Billiardchalktheif/Cargo_gaurdian_system/docs/(지정 비율) 작동코드 및 파이썬 프로그램.docx

<작동코드>-아두이노

// =====================================================

// 화물지킴이 최종 코드 - ESP32

// 퍼센트 방식 + 축적 감지 + raw/퍼센트 동시 출력

// =====================================================

#include <Wire.h>

#include <VL53L1X.h>

#include <HX711.h>

#include <LiquidCrystal_I2C.h>

#include <WiFi.h>

#include <WiFiUdp.h>

// ── Wi-Fi 설정 ──

const char* ssid = "Billiardchalktheif";

const char* password = "goqudeo1!";

const int UDP_PORT = 12345;

WiFiUDP udp;

// ── 핀 정의 ──

#define XSHUT_PIN 4

#define BUZZER_PIN 13

#define DOUT 16

#define SCK_HX 17

#define MPU_ADDR 0x68

#define RESET_BTN 12

#define MUTE_BTN 14

// ── 퍼센트 임계값 (실험 후 수정) ──

// 각 센서가 기준값 대비 몇 % 변화 시 경보

#define TILT_B 0.15 // 15% 변화 → 경고

#define TILT_C 0.25 // 25% 변화 → 위험

#define TENSION_B 0.15 // 15% 감소 → 경고

#define TENSION_C 0.30 // 30% 감소 → 위험

#define DIST_B 0.10 // 10% 변화 → 경고

#define DIST_C 0.20 // 20% 변화 → 위험

// ── 축적 감지 횟수 ──

#define ACCUM_COUNT 3 // 3회 연속 감지 시 경보

// ── 객체 생성 ──

VL53L1X vl53;

HX711 scale;

LiquidCrystal_I2C lcd(0x27, 16, 2);

long baseRaw = 0;

int baseDist = 0;

float baseTilt = 0;

bool isMuted = false;

// ── 축적 카운터 ──

int accumT = 0;

int accumF = 0;

int accumD = 0;

// ── 이동평균 필터 ──

#define FILTER_SIZE 5

long tensorBuf[FILTER_SIZE] = {0};

int distBuf[FILTER_SIZE] = {0};

float tiltBuf[FILTER_SIZE] = {0};

int fIdx = 0;

// ── MPU6050 직접 제어 ──

void mpuInit() {

Wire.beginTransmission(MPU_ADDR);

Wire.write(0x6B);

Wire.write(0x00);

Wire.endTransmission();

}

float getRawTilt() {

Wire.beginTransmission(MPU_ADDR);

Wire.write(0x3B);

Wire.endTransmission(false);

Wire.requestFrom(MPU_ADDR, 6, true);

int16_t ax = Wire.read() << 8 | Wire.read();

int16_t ay = Wire.read() << 8 | Wire.read();

int16_t az = Wire.read() << 8 | Wire.read();

float accY = ay / 16384.0;

float accZ = az / 16384.0;

tiltBuf[fIdx] = abs(atan2(accY, accZ) * 180.0 / PI);

float sum = 0;

for (int i = 0; i < FILTER_SIZE; i++) sum += tiltBuf[i];

return sum / FILTER_SIZE;

}

float getTilt() {

return abs(getRawTilt() - baseTilt);

}

long getFilteredTension() {

tensorBuf[fIdx] = scale.get_value(3);

long sum = 0;

for (int i = 0; i < FILTER_SIZE; i++) sum += tensorBuf[i];

return sum / FILTER_SIZE;

}

int getFilteredDist() {

distBuf[fIdx] = vl53.read();

int sum = 0;

for (int i = 0; i < FILTER_SIZE; i++) sum += distBuf[i];

return sum / FILTER_SIZE;

}

void sendData(String data) {

if (WiFi.status() == WL_CONNECTED) {

udp.beginPacket("255.255.255.255", UDP_PORT);

udp.print(data);

udp.endPacket();

}

Serial.println(data);

}

void resetBaseline() {

lcd.clear();

lcd.print("Resetting...");

delay(500);

scale.tare();

for (int i = 0; i < FILTER_SIZE; i++) {

tensorBuf[i] = scale.get_value(3);

distBuf[i] = vl53.read();

tiltBuf[i] = getRawTilt();

delay(100);

}

baseRaw = getFilteredTension();

baseDist = getFilteredDist();

baseTilt = getRawTilt();

// 축적 카운터 초기화

accumT = 0;

accumF = 0;

accumD = 0;

sendData("RESET");

lcd.clear();

lcd.print("RESET OK!");

delay(1000);

}

void setup() {

Serial.begin(115200);

Wire.begin(21, 22);

pinMode(BUZZER_PIN, OUTPUT);

pinMode(XSHUT_PIN, OUTPUT);

pinMode(RESET_BTN, INPUT_PULLUP);

pinMode(MUTE_BTN, INPUT_PULLUP);

lcd.init();

lcd.backlight();

lcd.setCursor(0, 0); lcd.print("Cargo Guardian");

lcd.setCursor(0, 1); lcd.print("Connecting...");

WiFi.begin(ssid, password);

int retry = 0;

while (WiFi.status() != WL_CONNECTED && retry < 20) {

delay(500);

Serial.print(".");

retry++;

}

if (WiFi.status() == WL_CONNECTED) {

Serial.println("\nWi-Fi 연결 성공!");

lcd.clear();

lcd.print("WiFi OK!");

lcd.setCursor(0, 1);

lcd.print(WiFi.localIP());

delay(2000);

} else {

Serial.println("\nWi-Fi 실패 - 오프라인 모드");

lcd.clear();

lcd.print("WiFi FAIL");

lcd.setCursor(0, 1);

lcd.print("Offline Mode");

delay(2000);

}

udp.begin(UDP_PORT);

mpuInit();

delay(100);

digitalWrite(XSHUT_PIN, LOW); delay(10);

digitalWrite(XSHUT_PIN, HIGH); delay(10);

vl53.setTimeout(500);

if (!vl53.init()) {

lcd.clear(); lcd.print("VL53 ERROR!");

while(1);

}

vl53.setDistanceMode(VL53L1X::Long);

vl53.startContinuous(50);

scale.begin(DOUT, SCK_HX);

delay(500);

scale.tare();

resetBaseline();

lcd.clear();

lcd.print("Ready!");

delay(1000);

}

void loop() {

// ── 영점 리셋 버튼 ──

if (digitalRead(RESET_BTN) == LOW) {

delay(50);

if (digitalRead(RESET_BTN) == LOW) {

resetBaseline();

while (digitalRead(RESET_BTN) == LOW);

}

}

// ── 음소거 버튼 ──

if (digitalRead(MUTE_BTN) == LOW) {

delay(50);

if (digitalRead(MUTE_BTN) == LOW) {

isMuted = !isMuted;

noTone(BUZZER_PIN);

lcd.clear();

if (isMuted) {

lcd.print("MUTE ON");

lcd.setCursor(0,1); lcd.print("Buzzer OFF");

} else {

lcd.print("MUTE OFF");

lcd.setCursor(0,1); lcd.print("Buzzer ON");

}

delay(800);

while (digitalRead(MUTE_BTN) == LOW);

}

}

// ── 센서 raw값 읽기 ──

float rawTilt = getTilt(); // 도(°)

long rawTension = getFilteredTension(); // raw값

int rawDist = getFilteredDist(); // mm

fIdx = (fIdx + 1) % FILTER_SIZE;

// ── 퍼센트 변화율 계산 ──

float tiltPct = rawTilt / (abs(baseTilt) + 1.0);

float tensionPct = (float)(baseRaw - rawTension) / (abs(baseRaw) + 1.0);

float distPct = (float)abs(rawDist - baseDist) / (abs(baseDist) + 1.0);

// 음수 방지 (장력이 오히려 늘었을 때)

if (tensionPct < 0) tensionPct = 0;

// ── 축적 감지 ──

// 자이로

if (tiltPct >= TILT_B) accumT++;

else accumT = 0;

// 장력

if (tensionPct >= TENSION_B) accumF++;

else accumF = 0;

// 거리

if (distPct >= DIST_B) accumD++;

else accumD = 0;

// ── 단계 판정 (축적 기반) ──

int sT = 0;

if (accumT >= ACCUM_COUNT && tiltPct >= TILT_C) sT = 3;

else if (accumT >= ACCUM_COUNT && tiltPct >= TILT_B) sT = 2;

else if (tiltPct >= TILT_B) sT = 1;

int sF = 0;

if (accumF >= ACCUM_COUNT && tensionPct >= TENSION_C) sF = 3;

else if (accumF >= ACCUM_COUNT && tensionPct >= TENSION_B) sF = 2;

else if (tensionPct >= TENSION_B) sF = 1;

int sD = 0;

if (accumD >= ACCUM_COUNT && distPct >= DIST_C) sD = 3;

else if (accumD >= ACCUM_COUNT && distPct >= DIST_B) sD = 2;

else if (distPct >= DIST_B) sD = 1;

int triggered = (sT>0?1:0) + (sF>0?1:0) + (sD>0?1:0);

int maxStage = max(sT, max(sF, sD));

int level = 0;

if (triggered == 3 || maxStage == 3) level = 3;

else if (triggered >= 2 || maxStage == 2) level = 2;

else if (triggered >= 1) level = 1;

String alarm = "NORMAL";

if (level == 3) alarm = "DANGER";

else if (level == 2) alarm = "WARNING";

else if (level == 1) alarm = "CAUTION";

// ── LCD 출력 ──

lcd.clear();

if (level == 0) {

lcd.setCursor(0, 0);

if (isMuted) lcd.print("NORMAL [MUTE] ");

else lcd.print("STATUS: NORMAL ");

lcd.setCursor(0, 1);

lcd.print("T:"); lcd.print((int)(tiltPct*100));

lcd.print("% F:"); lcd.print((int)(tensionPct*100));

lcd.print("% D:"); lcd.print((int)(distPct*100));

lcd.print("%");

} else {

lcd.setCursor(0, 0);

if (level == 3) lcd.print("[C] DANGER!!!!!");

else if (level == 2) lcd.print("[B] WARNING!!! ");

else lcd.print("[A] CAUTION ");

lcd.setCursor(0, 1);

String msg = "";

if (sT > 0) msg += "Tilt ";

if (sF > 0) msg += "Load ";

if (sD > 0) msg += "Dist ";

if (isMuted) msg += "[M]";

lcd.print(msg);

}

// ── 부저 출력 ──

if (!isMuted) {

if (level == 0 || level == 1) {

noTone(BUZZER_PIN);

} else if (level == 2) {

tone(BUZZER_PIN, 1000, 300);

delay(600);

noTone(BUZZER_PIN);

} else {

tone(BUZZER_PIN, 2000);

}

} else {

noTone(BUZZER_PIN);

}

// ── CSV 전송 (raw + 퍼센트 둘 다) ──

String csvData = "CSV," +

String(millis()) + "," +

String(rawTilt) + "," + // raw 기울기(도)

String(baseRaw - rawTension) + "," + // raw 장력변화

String(abs(rawDist-baseDist)) + "," + // raw 거리변화(mm)

String(tiltPct * 100.0, 1) + "," + // 기울기 변화율(%)

String(tensionPct * 100.0, 1) + "," + // 장력 변화율(%)

String(distPct * 100.0, 1) + "," + // 거리 변화율(%)

String(sT) + "," +

String(sF) + "," +

String(sD) + "," +

String(triggered) + "," +

String(level) + "," +

alarm;

sendData(csvData);

delay(200);

}

<파이썬>

import socket

import openpyxl

from openpyxl.styles import PatternFill, Font

from datetime import datetime

# ── 설정 ──

UDP_PORT = 12345

BUFFER_SIZE = 1024

timestamp = datetime.now().strftime("%Y%m%d_%H%M%S")

FILENAME = f"C:/Users/mugi4/Desktop/가천대/공모전/화물지킴이_실험데이터_{timestamp}.xlsx"

# ── 색상 ──

FILL_CAUTION = PatternFill("solid", fgColor="FFFF00")

FILL_WARNING = PatternFill("solid", fgColor="FFA500")

FILL_DANGER = PatternFill("solid", fgColor="FF0000")

FILL_RESET = PatternFill("solid", fgColor="00CC00")

FONT_WHITE = Font(color="FFFFFF", bold=True)

FONT_BLACK = Font(color="000000", bold=False)

# ── 엑셀 초기화 ──

wb = openpyxl.Workbook()

ws = wb.active

ws.title = "실험데이터"

# raw + 퍼센트 둘 다 포함한 헤더

headers = [

"시간(ms)",

"기울기raw(°)", "장력raw", "거리raw(mm)",

"기울기(%)", "장력(%)", "거리(%)",

"자이로단계", "장력단계", "거리단계",

"활성센서수", "최종단계", "경보상태", "기록시각"

]

ws.append(headers)

header_fill = PatternFill("solid", fgColor="1F4E79")

for cell in ws[1]:

cell.fill = header_fill

cell.font = Font(color="FFFFFF", bold=True)

col_widths = [12, 14, 12, 14, 12, 10, 10, 12, 10, 10, 12, 12, 12, 20]

for i, width in enumerate(col_widths, 1):

ws.column_dimensions[openpyxl.utils.get_column_letter(i)].width = width

# ── UDP 소켓 ──

sock = socket.socket(socket.AF_INET, socket.SOCK_DGRAM)

sock.bind(("0.0.0.0", UDP_PORT))

sock.settimeout(1.0)

print("수신 대기 중...")

print(f"저장 파일: {FILENAME}")

print("종료: Ctrl+C")

print("=" * 50)

row = 2

try:

while True:

try:

data, addr = sock.recvfrom(BUFFER_SIZE)

line = data.decode("utf-8", errors="ignore").strip()

except socket.timeout:

continue

if not line:

continue

# 리셋 처리

if line == "RESET":

now = datetime.now().strftime("%H:%M:%S")

ws.append(["===RESET==="] + [""] * 12 + [now])

for col in range(1, 15):

ws.cell(row=row, column=col).fill = FILL_RESET

ws.cell(row=row, column=col).font = FONT_WHITE

row += 1

wb.save(FILENAME)

print(f"[{now}] ===== 영점 리셋 =====")

continue

if not line.startswith("CSV,"):

continue

parts = line.split(",")

parts = parts[1:]

if len(parts) != 13:

continue

try:

time_ms = int(parts[0])

raw_tilt = float(parts[1])

raw_tension = int(parts[2])

raw_dist = int(parts[3])

pct_tilt = float(parts[4])

pct_tension = float(parts[5])

pct_dist = float(parts[6])

tilt_lv = int(parts[7])

tension_lv = int(parts[8])

dist_lv = int(parts[9])

triggered = int(parts[10])

level = int(parts[11])

alarm = parts[12]

now = datetime.now().strftime("%H:%M:%S")

ws.append([

time_ms,

raw_tilt, raw_tension, raw_dist,

pct_tilt, pct_tension, pct_dist,

tilt_lv, tension_lv, dist_lv,

triggered, level, alarm, now

])

# 경보 상태 열 색칠 (13번)

if alarm == "DANGER":

ws.cell(row=row, column=13).fill = FILL_DANGER

ws.cell(row=row, column=13).font = FONT_WHITE

elif alarm == "WARNING":

ws.cell(row=row, column=13).fill = FILL_WARNING

elif alarm == "CAUTION":

ws.cell(row=row, column=13).fill = FILL_CAUTION

# 퍼센트 열 색칠 (5,6,7번)

pct_fills = [pct_tilt, pct_tension, pct_dist]

pct_lvs = [tilt_lv, tension_lv, dist_lv]

for i, (pct, lv) in enumerate(zip(pct_fills, pct_lvs)):

col = 5 + i

if lv == 3:

ws.cell(row=row, column=col).fill = FILL_DANGER

ws.cell(row=row, column=col).font = FONT_WHITE

elif lv == 2:

ws.cell(row=row, column=col).fill = FILL_WARNING

elif lv == 1:

ws.cell(row=row, column=col).fill = FILL_CAUTION

row += 1

print(f"[{now}] "

f"기울기:{raw_tilt:.1f}°({pct_tilt:.1f}%) "

f"장력:{raw_tension}({pct_tension:.1f}%) "

f"거리:{raw_dist}mm({pct_dist:.1f}%) "

f"→ {alarm}")

if row % 100 == 0:

wb.save(FILENAME)

print(f"자동 저장! ({row}행)")

except ValueError:

continue

except KeyboardInterrupt:

print("\n종료 중...")

finally:

try:

wb.save(FILENAME)

print(f"저장 완료! → {FILENAME}")

except Exception as e:

print(f"저장 실패: {e}")

finally:

sock.close()
