Billiardchalktheif/Cargo_gaurdian_system/docs/(지정 임계값)아두이노 작동 확인 코드 및 핀 위치.docx

화물이탈방지시스템 프로토타입(최종 합침)

<핀 위치>

부품 | 핀 | ESP32
VL53L1X | VIN | 3.3V
VL53L1X | GND | GND
VL53L1X | SDA | GPIO21
VL53L1X | SCL | GPIO22
VL53L1X | XSHUT | GPIO4
MPU6050 | VCC | 3.3V
MPU6050 | GND | GND
MPU6050 | SDA | GPIO21
MPU6050 | SCL | GPIO22
MPU6050 | AD0 | GND
HX711 | VCC | 3.3V
HX711 | GND | GND
HX711 | DT | GPIO16
HX711 | SCK | GPIO17
LCD | VCC | 5V
LCD | GND | GND
LCD | SDA | GPIO21
LCD | SCL | GPIO22
부저 | S | GPIO13
부저 | 가운데 | 5V
부저 | - | GND
푸시버튼 | 파랑1 | GPIO12
푸시버튼 | 파랑 2 | GND

<작동 코드>

// =====================================================

// 화물지킴이 최종 코드 - ESP32

// 버튼2개 (영점리셋 + 음소거) 버전

// =====================================================

#include <Wire.h>

#include <VL53L1X.h>

#include <HX711.h>

#include <LiquidCrystal_I2C.h>

#include <WiFi.h>

#include <WiFiUdp.h>

// ── Wi-Fi 설정 ──

const char* ssid = "Billiardchalktheif";

const char* password = "goqudeo1!";

const int UDP_PORT = 12345;

WiFiUDP udp;

// ── 핀 정의 ──

#define XSHUT_PIN 4

#define BUZZER_PIN 13

#define DOUT 16

#define SCK_HX 17

#define MPU_ADDR 0x68

#define RESET_BTN 12 // 영점 리셋 버튼

#define MUTE_BTN 14 // 음소거 버튼

// ── 임계값 (실험 후 수정) ──

#define TILT_B 10.0

#define TILT_C 15.0

#define TENSION_B 5000

#define TENSION_C 50000

#define DIST_B 100

#define DIST_C 200

// ── 객체 생성 ──

VL53L1X vl53;

HX711 scale;

LiquidCrystal_I2C lcd(0x27, 16, 2);

long baseRaw = 0;

int baseDist = 0;

float baseTilt = 0;

bool isMuted = false;

// ── 이동평균 필터 ──

#define FILTER_SIZE 5

long tensorBuf[FILTER_SIZE] = {0};

int distBuf[FILTER_SIZE] = {0};

float tiltBuf[FILTER_SIZE] = {0};

int fIdx = 0;

// ── MPU6050 직접 제어 ──

void mpuInit() {

Wire.beginTransmission(MPU_ADDR);

Wire.write(0x6B);

Wire.write(0x00);

Wire.endTransmission();

}

float getRawTilt() {

Wire.beginTransmission(MPU_ADDR);

Wire.write(0x3B);

Wire.endTransmission(false);

Wire.requestFrom(MPU_ADDR, 6, true);

int16_t ax = Wire.read() << 8 | Wire.read();

int16_t ay = Wire.read() << 8 | Wire.read();

int16_t az = Wire.read() << 8 | Wire.read();

float accY = ay / 16384.0;

float accZ = az / 16384.0;

tiltBuf[fIdx] = abs(atan2(accY, accZ) * 180.0 / PI);

float sum = 0;

for (int i = 0; i < FILTER_SIZE; i++) sum += tiltBuf[i];

return sum / FILTER_SIZE;

}

float getTilt() {

return abs(getRawTilt() - baseTilt);

}

long getFilteredTension() {

tensorBuf[fIdx] = scale.get_value(3);

long sum = 0;

for (int i = 0; i < FILTER_SIZE; i++) sum += tensorBuf[i];

return sum / FILTER_SIZE;

}

int getFilteredDist() {

distBuf[fIdx] = vl53.read();

int sum = 0;

for (int i = 0; i < FILTER_SIZE; i++) sum += distBuf[i];

return sum / FILTER_SIZE;

}

// ── 데이터 전송 ──

void sendData(String data) {

if (WiFi.status() == WL_CONNECTED) {

udp.beginPacket("255.255.255.255", UDP_PORT);

udp.print(data);

udp.endPacket();

}

Serial.println(data);

}

// ── 영점 리셋 ──

void resetBaseline() {

lcd.clear();

lcd.print("Resetting...");

delay(500);

scale.tare();

for (int i = 0; i < FILTER_SIZE; i++) {

tensorBuf[i] = scale.get_value(3);

distBuf[i] = vl53.read();

tiltBuf[i] = getRawTilt();

delay(100);

}

baseRaw = getFilteredTension();

baseDist = getFilteredDist();

baseTilt = getRawTilt();

sendData("RESET");

lcd.clear();

lcd.print("RESET OK!");

delay(1000);

}

void setup() {

Serial.begin(115200);

Wire.begin(21, 22);

pinMode(BUZZER_PIN, OUTPUT);

pinMode(XSHUT_PIN, OUTPUT);

pinMode(RESET_BTN, INPUT_PULLUP);

pinMode(MUTE_BTN, INPUT_PULLUP);

// LCD 초기화

lcd.init();

lcd.backlight();

lcd.setCursor(0, 0); lcd.print("Cargo Guardian");

lcd.setCursor(0, 1); lcd.print("Connecting...");

// Wi-Fi 연결

WiFi.begin(ssid, password);

int retry = 0;

while (WiFi.status() != WL_CONNECTED && retry < 20) {

delay(500);

Serial.print(".");

retry++;

}

if (WiFi.status() == WL_CONNECTED) {

Serial.println("\nWi-Fi 연결 성공!");

lcd.clear();

lcd.print("WiFi OK!");

lcd.setCursor(0, 1);

lcd.print(WiFi.localIP());

delay(2000);

} else {

Serial.println("\nWi-Fi 실패 - 오프라인 모드");

lcd.clear();

lcd.print("WiFi FAIL");

lcd.setCursor(0, 1);

lcd.print("Offline Mode");

delay(2000);

}

udp.begin(UDP_PORT);

// MPU6050 초기화

mpuInit();

delay(100);

// VL53L1X 초기화

digitalWrite(XSHUT_PIN, LOW); delay(10);

digitalWrite(XSHUT_PIN, HIGH); delay(10);

vl53.setTimeout(500);

if (!vl53.init()) {

lcd.clear(); lcd.print("VL53 ERROR!");

while(1);

}

vl53.setDistanceMode(VL53L1X::Long);

vl53.startContinuous(50);

// HX711 초기화

scale.begin(DOUT, SCK_HX);

delay(500);

scale.tare();

// 영점 초기 설정

resetBaseline();

lcd.clear();

lcd.print("Ready!");

delay(1000);

}

void loop() {

// ── 영점 리셋 버튼 ──

if (digitalRead(RESET_BTN) == LOW) {

delay(50);

if (digitalRead(RESET_BTN) == LOW) {

resetBaseline();

while (digitalRead(RESET_BTN) == LOW);

}

}

// ── 음소거 버튼 (토글) ──

if (digitalRead(MUTE_BTN) == LOW) {

delay(50);

if (digitalRead(MUTE_BTN) == LOW) {

isMuted = !isMuted;

noTone(BUZZER_PIN);

lcd.clear();

if (isMuted) {

lcd.print("MUTE ON");

lcd.setCursor(0, 1);

lcd.print("Buzzer OFF");

} else {

lcd.print("MUTE OFF");

lcd.setCursor(0, 1);

lcd.print("Buzzer ON");

}

delay(800);

while (digitalRead(MUTE_BTN) == LOW);

}

}

// ── 센서 읽기 ──

float tilt = getTilt();

long curRaw = getFilteredTension();

long tensionDiff = baseRaw - curRaw;

int curDist = getFilteredDist();

int distDiff = abs(curDist - baseDist);

fIdx = (fIdx + 1) % FILTER_SIZE;

// ── 교차회로 단계 판정 ──

int sT = (tilt >= TILT_C) ? 3 : (tilt >= TILT_B) ? 2 : 0;

int sF = (tensionDiff >= TENSION_C) ? 3 : (tensionDiff >= TENSION_B) ? 2 : 0;

int sD = (distDiff >= DIST_C) ? 3 : (distDiff >= DIST_B) ? 2 : 0;

int triggered = (sT>0?1:0) + (sF>0?1:0) + (sD>0?1:0);

int maxStage = max(sT, max(sF, sD));

int level = 0;

if (triggered == 3 || maxStage == 3) level = 3;

else if (triggered >= 2 || maxStage == 2) level = 2;

else if (triggered >= 1) level = 1;

String alarm = "NORMAL";

if (level == 3) alarm = "DANGER";

else if (level == 2) alarm = "WARNING";

else if (level == 1) alarm = "CAUTION";

// ── LCD 출력 ──

lcd.clear();

if (level == 0) {

lcd.setCursor(0, 0);

if (isMuted) lcd.print("NORMAL [MUTE] ");

else lcd.print("STATUS: NORMAL ");

lcd.setCursor(0, 1);

lcd.print("T:"); lcd.print((int)tilt);

lcd.print(" F:"); lcd.print(tensionDiff/1000);

lcd.print(" D:"); lcd.print(distDiff);

} else {

lcd.setCursor(0, 0);

if (level == 3) lcd.print("[C] DANGER!!!!!");

else if (level == 2) lcd.print("[B] WARNING!!! ");

else lcd.print("[A] CAUTION ");

lcd.setCursor(0, 1);

String sensorMsg = "";

if (sT > 0) sensorMsg += "Tilt ";

if (sF > 0) sensorMsg += "Load ";

if (sD > 0) sensorMsg += "Dist ";

if (isMuted) sensorMsg += "[M]";

lcd.print(sensorMsg);

}

// ── 부저 출력 ──

if (!isMuted) {

if (level == 0 || level == 1) {

noTone(BUZZER_PIN);

} else if (level == 2) {

tone(BUZZER_PIN, 1000, 300);

delay(600);

noTone(BUZZER_PIN);

} else {

tone(BUZZER_PIN, 2000);

}

} else {

noTone(BUZZER_PIN);

}

// ── CSV 전송 ──

String csvData = "CSV," +

String(millis()) + "," +

String(tilt) + "," +

String(tensionDiff) + "," +

String(distDiff) + "," +

String(sT) + "," +

String(sF) + "," +

String(sD) + "," +

String(triggered) + "," +

String(level) + "," +

alarm;

sendData(csvData);

delay(200);

}}

센서 값 엑셀 자동기입 파이썬 프로그램

import socket

import openpyxl

from openpyxl.styles import PatternFill, Font

from datetime import datetime

import time

# ── 설정 ──

UDP_PORT = 12345

BUFFER_SIZE = 1024

timestamp = datetime.now().strftime("%Y%m%d_%H%M%S")

FILENAME = f"C:/Users/mugi4/Desktop/가천대/공모전/화물지킴이_실험데이터_{timestamp}.xlsx"

# ── 색상 정의 ──

FILL_CAUTION = PatternFill("solid", fgColor="FFFF00")

FILL_WARNING = PatternFill("solid", fgColor="FFA500")

FILL_DANGER = PatternFill("solid", fgColor="FF0000")

FILL_RESET = PatternFill("solid", fgColor="00CC00")

FONT_WHITE = Font(color="FFFFFF", bold=True)

FONT_BLACK = Font(color="000000", bold=False)

# ── 엑셀 초기화 ──

wb = openpyxl.Workbook()

ws = wb.active

ws.title = "실험데이터"

headers = [

"시간(ms)", "기울기(deg)", "장력변화", "거리변화(mm)",

"자이로단계", "장력단계", "거리단계",

"활성센서수", "최종단계", "경보상태", "기록시각"

]

ws.append(headers)

header_fill = PatternFill("solid", fgColor="1F4E79")

for cell in ws[1]:

cell.fill = header_fill

cell.font = Font(color="FFFFFF", bold=True)

col_widths = [12, 14, 14, 14, 12, 12, 12, 12, 12, 12, 20]

for i, width in enumerate(col_widths, 1):

ws.column_dimensions[openpyxl.utils.get_column_letter(i)].width = width

# ── UDP 소켓 설정 ──

sock = socket.socket(socket.AF_INET, socket.SOCK_DGRAM)

sock.bind(("0.0.0.0", UDP_PORT))

sock.settimeout(1.0)

print("Wi-Fi 데이터 수신 대기 중...")

print(f"저장 파일: {FILENAME}")

print("종료하려면 Ctrl+C 누르세요.")

print("=" * 50)

row = 2

try:

while True:

try:

data, addr = sock.recvfrom(BUFFER_SIZE)

line = data.decode("utf-8", errors="ignore").strip()

except socket.timeout:

continue

if not line:

continue

# 리셋 처리

if line == "RESET":

now = datetime.now().strftime("%H:%M:%S")

ws.append(["===RESET===", "", "", "", "", "", "", "", "", "RESET", now])

for col in range(1, 12):

ws.cell(row=row, column=col).fill = FILL_RESET

ws.cell(row=row, column=col).font = FONT_WHITE

row += 1

wb.save(FILENAME)

print(f"[{now}] ===== 영점 리셋 =====")

continue

# CSV 처리

if not line.startswith("CSV,"):

continue

parts = line.split(",")

parts = parts[1:]

if len(parts) != 10:

continue

try:

time_ms = int(parts[0])

tilt = float(parts[1])

tension = int(parts[2])

dist = int(parts[3])

tilt_lv = int(parts[4])

tension_lv = int(parts[5])

dist_lv = int(parts[6])

triggered = int(parts[7])

level = int(parts[8])

alarm = parts[9]

now = datetime.now().strftime("%H:%M:%S")

ws.append([

time_ms, tilt, tension, dist,

tilt_lv, tension_lv, dist_lv,

triggered, level, alarm, now

])

# 경보 상태 열 색칠

if alarm == "DANGER":

ws.cell(row=row, column=10).fill = FILL_DANGER

ws.cell(row=row, column=10).font = FONT_WHITE

elif alarm == "WARNING":

ws.cell(row=row, column=10).fill = FILL_WARNING

elif alarm == "CAUTION":

ws.cell(row=row, column=10).fill = FILL_CAUTION

# 자이로 열

if tilt_lv == 3:

ws.cell(row=row, column=2).fill = FILL_DANGER

ws.cell(row=row, column=2).font = FONT_WHITE

elif tilt_lv == 2:

ws.cell(row=row, column=2).fill = FILL_WARNING

elif tilt_lv == 1:

ws.cell(row=row, column=2).fill = FILL_CAUTION

# 장력 열

if tension_lv == 3:

ws.cell(row=row, column=3).fill = FILL_DANGER

ws.cell(row=row, column=3).font = FONT_WHITE

elif tension_lv == 2:

ws.cell(row=row, column=3).fill = FILL_WARNING

elif tension_lv == 1:

ws.cell(row=row, column=3).fill = FILL_CAUTION

# 거리 열

if dist_lv == 3:

ws.cell(row=row, column=4).fill = FILL_DANGER

ws.cell(row=row, column=4).font = FONT_WHITE

elif dist_lv == 2:

ws.cell(row=row, column=4).fill = FILL_WARNING

elif dist_lv == 1:

ws.cell(row=row, column=4).fill = FILL_CAUTION

row += 1

print(f"[{now}] 기울기:{tilt:.1f}deg "

f"장력:{tension} "

f"거리:{dist}mm "

f"활성:{triggered}개 → {alarm}")

if row % 100 == 0:

try:

wb.save(FILENAME)

print(f"자동 저장! ({row}행)")

except Exception as e:

print(f"저장 오류: {e}")

except ValueError:

continue

except KeyboardInterrupt:

print("\n종료 중...")

finally:

try:

wb.save(FILENAME)

print(f"최종 저장 완료! → {FILENAME}")

except Exception as e:

print(f"저장 실패: {e}")

finally:

sock.close()
