Billiardchalktheif/Cargo_gaurdian_system/docs/(총점제) 코드 및 파이썬.docx

<작동 코드>

// =====================================================

// 화물지킴이 최종 코드 - ESP32

// 총점제 방식 (장력 메인 + 보조센서)

// NORMAL → WARNING → DANGER

// =====================================================

#include <Wire.h>

#include <VL53L1X.h>

#include <HX711.h>

#include <LiquidCrystal_I2C.h>

#include <WiFi.h>

#include <WiFiUdp.h>

// ── Wi-Fi 설정 ──

const char* ssid = "Billiardchalktheif";

const char* password = "goqudeo1!";

const int UDP_PORT = 12345;

WiFiUDP udp;

// ── 핀 정의 ──

#define XSHUT_PIN 4

#define BUZZER_PIN 13

#define DOUT 16

#define SCK_HX 17

#define MPU_ADDR 0x68

#define RESET_BTN 12

#define MUTE_BTN 14

// ── 센서별 임계값 (경미/심각 2단계) ──

#define TENSION_MINOR 0.15 // 장력 경미: 2점

#define TENSION_MAJOR 0.30 // 장력 심각: 4점

#define TILT_MINOR 0.23 // 자이로 경미: 1점

#define TILT_MAJOR 0.37 // 자이로 심각: 2점

#define DIST_MINOR 0.20 // 거리 경미: 1점

#define DIST_MAJOR 0.32 // 거리 심각: 2점

// ── 총점 임계값 ──

#define SCORE_WARNING 3 // 3점 이상 → WARNING

#define SCORE_DANGER 6 // 6점 이상 → DANGER

// ── 축적 감지 횟수 ──

#define ACCUM_COUNT 5

// ── 객체 생성 ──

VL53L1X vl53;

HX711 scale;

LiquidCrystal_I2C lcd(0x27, 16, 2);

long baseRaw = 0;

int baseDist = 0;

float baseTilt = 0;

bool isMuted = false;

// ── 축적 카운터 ──

int accumT = 0;

int accumF = 0;

int accumD = 0;

// ── 이동평균 필터 ──

#define FILTER_SIZE 5

long tensorBuf[FILTER_SIZE] = {0};

int distBuf[FILTER_SIZE] = {0};

float tiltBuf[FILTER_SIZE] = {0};

int fIdx = 0;

// ── MPU6050 직접 제어 ──

void mpuInit() {

Wire.beginTransmission(MPU_ADDR);

Wire.write(0x6B);

Wire.write(0x00);

Wire.endTransmission();

}

float getRawTilt() {

Wire.beginTransmission(MPU_ADDR);

Wire.write(0x3B);

Wire.endTransmission(false);

Wire.requestFrom(MPU_ADDR, 6, true);

int16_t ax = Wire.read() << 8 | Wire.read();

int16_t ay = Wire.read() << 8 | Wire.read();

int16_t az = Wire.read() << 8 | Wire.read();

float accY = ay / 16384.0;

float accZ = az / 16384.0;

tiltBuf[fIdx] = abs(atan2(accY, accZ) * 180.0 / PI);

float sum = 0;

for (int i = 0; i < FILTER_SIZE; i++) sum += tiltBuf[i];

return sum / FILTER_SIZE;

}

float getTilt() {

return abs(getRawTilt() - baseTilt);

}

long getFilteredTension() {

tensorBuf[fIdx] = scale.get_value(3);

long sum = 0;

for (int i = 0; i < FILTER_SIZE; i++) sum += tensorBuf[i];

return sum / FILTER_SIZE;

}

int getFilteredDist() {

distBuf[fIdx] = vl53.read();

int sum = 0;

for (int i = 0; i < FILTER_SIZE; i++) sum += distBuf[i];

return sum / FILTER_SIZE;

}

void sendData(String data) {

if (WiFi.status() == WL_CONNECTED) {

udp.beginPacket("255.255.255.255", UDP_PORT);

udp.print(data);

udp.endPacket();

}

Serial.println(data);

}

void resetBaseline() {

lcd.clear();

lcd.print("Resetting...");

delay(500);

scale.tare();

for (int i = 0; i < FILTER_SIZE; i++) {

tensorBuf[i] = scale.get_value(3);

distBuf[i] = vl53.read();

tiltBuf[i] = getRawTilt();

delay(100);

}

baseRaw = getFilteredTension();

baseDist = getFilteredDist();

baseTilt = getRawTilt();

accumT = 0;

accumF = 0;

accumD = 0;

sendData("RESET");

lcd.clear();

lcd.print("RESET OK!");

delay(1000);

}

void setup() {

Serial.begin(115200);

Wire.begin(21, 22);

pinMode(BUZZER_PIN, OUTPUT);

pinMode(XSHUT_PIN, OUTPUT);

pinMode(RESET_BTN, INPUT_PULLUP);

pinMode(MUTE_BTN, INPUT_PULLUP);

lcd.init();

lcd.backlight();

lcd.setCursor(0, 0); lcd.print("Cargo Guardian");

lcd.setCursor(0, 1); lcd.print("Connecting...");

WiFi.begin(ssid, password);

int retry = 0;

while (WiFi.status() != WL_CONNECTED && retry < 20) {

delay(500);

Serial.print(".");

retry++;

}

if (WiFi.status() == WL_CONNECTED) {

Serial.println("\nWi-Fi 연결 성공!");

lcd.clear();

lcd.print("WiFi OK!");

lcd.setCursor(0, 1);

lcd.print(WiFi.localIP());

delay(2000);

} else {

Serial.println("\nWi-Fi 실패 - 오프라인 모드");

lcd.clear();

lcd.print("WiFi FAIL");

lcd.setCursor(0, 1);

lcd.print("Offline Mode");

delay(2000);

}

udp.begin(UDP_PORT);

mpuInit();

delay(100);

digitalWrite(XSHUT_PIN, LOW); delay(10);

digitalWrite(XSHUT_PIN, HIGH); delay(10);

vl53.setTimeout(500);

if (!vl53.init()) {

lcd.clear(); lcd.print("VL53 ERROR!");

while(1);

}

vl53.setDistanceMode(VL53L1X::Long);

vl53.startContinuous(50);

scale.begin(DOUT, SCK_HX);

delay(500);

scale.tare();

resetBaseline();

lcd.clear();

lcd.print("Ready!");

delay(1000);

}

void loop() {

// ── 영점 리셋 버튼 ──

if (digitalRead(RESET_BTN) == LOW) {

delay(50);

if (digitalRead(RESET_BTN) == LOW) {

resetBaseline();

while (digitalRead(RESET_BTN) == LOW);

}

}

// ── 음소거 버튼 ──

if (digitalRead(MUTE_BTN) == LOW) {

delay(50);

if (digitalRead(MUTE_BTN) == LOW) {

isMuted = !isMuted;

noTone(BUZZER_PIN);

lcd.clear();

if (isMuted) {

lcd.print("MUTE ON");

lcd.setCursor(0,1); lcd.print("Buzzer OFF");

} else {

lcd.print("MUTE OFF");

lcd.setCursor(0,1); lcd.print("Buzzer ON");

}

delay(800);

while (digitalRead(MUTE_BTN) == LOW);

}

}

// ── 센서 raw값 읽기 ──

float rawTilt = getTilt();

long rawTension = getFilteredTension();

int rawDist = getFilteredDist();

fIdx = (fIdx + 1) % FILTER_SIZE;

// ── 퍼센트 변화율 계산 ──

float tiltPct = rawTilt / (abs(baseTilt) + 1.0);

float tensionPct = (float)(abs(baseRaw) - abs(rawTension))

/ (abs(baseRaw) + 1.0); // 감소 시 양수

float distPct = (float)abs(rawDist - baseDist)

/ (abs(baseDist) + 1.0);

// ── 축적 카운터 업데이트 ──

if (tensionPct >= TENSION_MINOR) accumF++;

else accumF = 0;

if (tiltPct >= TILT_MINOR) accumT++;

else accumT = 0;

if (distPct >= DIST_MINOR) accumD++;

else accumD = 0;

// ── 센서별 점수 계산 ──

int scoreF = 0;

int scoreT = 0;

int scoreD = 0;

// 장력 점수 (메인 - 최대 4점)

if (accumF >= ACCUM_COUNT) {

if (tensionPct >= TENSION_MAJOR) scoreF = 4;

else if (tensionPct >= TENSION_MINOR) scoreF = 2;

}

// 자이로 점수 (보조 - 최대 2점)

if (accumT >= ACCUM_COUNT) {

if (tiltPct >= TILT_MAJOR) scoreT = 2;

else if (tiltPct >= TILT_MINOR) scoreT = 1;

}

// 거리 점수 (보조 - 최대 2점)

if (accumD >= ACCUM_COUNT) {

if (distPct >= DIST_MAJOR) scoreD = 2;

else if (distPct >= DIST_MINOR) scoreD = 1;

}

// ── 총점 계산 ──

int totalScore = scoreF + scoreT + scoreD;

// ── 단계 판정 ──

int level = 0;

if (totalScore >= SCORE_DANGER) level = 2; // DANGER

else if (totalScore >= SCORE_WARNING) level = 1; // WARNING

String alarm = "NORMAL";

if (level == 2) alarm = "DANGER";

else if (level == 1) alarm = "WARNING";

// ── LCD 출력 ──

lcd.clear();

if (level == 0) {

lcd.setCursor(0, 0);

if (isMuted) lcd.print("NORMAL [MUTE] ");

else lcd.print("STATUS: NORMAL ");

lcd.setCursor(0, 1);

lcd.print("T:"); lcd.print((int)(tiltPct*100));

lcd.print("% F:"); lcd.print((int)(tensionPct*100));

lcd.print("% D:"); lcd.print((int)(distPct*100));

lcd.print("%");

noTone(BUZZER_PIN);

} else if (level == 1) {

lcd.setCursor(0, 0); lcd.print("[WARNING] ");

lcd.setCursor(0, 1);

String msg = "";

if (scoreF > 0) msg += "Load ";

if (scoreT > 0) msg += "Tilt ";

if (scoreD > 0) msg += "Dist ";

msg += "(" + String(totalScore) + "pt)";

lcd.print(msg);

if (!isMuted) {

tone(BUZZER_PIN, 1000, 300);

delay(600);

noTone(BUZZER_PIN);

}

} else {

lcd.setCursor(0, 0); lcd.print("[DANGER!!!] ");

lcd.setCursor(0, 1);

String msg = "";

if (scoreF > 0) msg += "Load ";

if (scoreT > 0) msg += "Tilt ";

if (scoreD > 0) msg += "Dist ";

msg += "(" + String(totalScore) + "pt)";

lcd.print(msg);

if (!isMuted) {

tone(BUZZER_PIN, 2000);

} else {

noTone(BUZZER_PIN);

}

}

// ── CSV 전송 ──

String csvData = "CSV," +

String(millis()) + "," +

String(rawTilt) + "," +

String(abs(baseRaw) - abs(rawTension)) + "," +

String(abs(rawDist - baseDist)) + "," +

String(tiltPct * 100.0, 1) + "," +

String(tensionPct * 100.0, 1) + "," +

String(distPct * 100.0, 1) + "," +

String(scoreT) + "," +

String(scoreF) + "," +

String(scoreD) + "," +

String(totalScore) + "," +

String(level) + "," +

alarm;

sendData(csvData);

delay(200);

}

<파이썬>

import socket

import openpyxl

from openpyxl.styles import PatternFill, Font

from datetime import datetime

# ── 설정 ──

UDP_PORT = 12345

BUFFER_SIZE = 1024

timestamp = datetime.now().strftime("%Y%m%d_%H%M%S")

FILENAME = f"C:/Users/mugi4/Desktop/가천대/공모전/화물지킴이_실험데이터_{timestamp}.xlsx"

# ── 색상 정의 ──

FILL_WARNING = PatternFill("solid", fgColor="FFA500") # 주황

FILL_DANGER = PatternFill("solid", fgColor="FF0000") # 빨강

FILL_RESET = PatternFill("solid", fgColor="00CC00") # 초록

FONT_WHITE = Font(color="FFFFFF", bold=True)

FONT_BLACK = Font(color="000000", bold=False)

# ── 엑셀 초기화 ──

wb = openpyxl.Workbook()

ws = wb.active

ws.title = "실험데이터"

headers = [

"시간(ms)",

"기울기raw(°)", "장력raw", "거리raw(mm)",

"기울기(%)", "장력(%)", "거리(%)",

"자이로점수", "장력점수", "거리점수",

"총점", "최종단계", "경보상태", "기록시각"

]

ws.append(headers)

header_fill = PatternFill("solid", fgColor="1F4E79")

for cell in ws[1]:

cell.fill = header_fill

cell.font = Font(color="FFFFFF", bold=True)

col_widths = [12, 14, 12, 14, 12, 10, 10, 12, 12, 12, 10, 12, 12, 20]

for i, width in enumerate(col_widths, 1):

ws.column_dimensions[openpyxl.utils.get_column_letter(i)].width = width

# ── UDP 소켓 ──

sock = socket.socket(socket.AF_INET, socket.SOCK_DGRAM)

sock.bind(("0.0.0.0", UDP_PORT))

sock.settimeout(1.0)

print("수신 대기 중...")

print(f"저장 파일: {FILENAME}")

print("종료: Ctrl+C")

print("=" * 50)

row = 2

try:

while True:

try:

data, addr = sock.recvfrom(BUFFER_SIZE)

line = data.decode("utf-8", errors="ignore").strip()

except socket.timeout:

continue

if not line:

continue

# ── 리셋 처리 ──

if line == "RESET":

now = datetime.now().strftime("%H:%M:%S")

ws.append(["===RESET==="] + [""] * 12 + [now])

for col in range(1, 15):

ws.cell(row=row, column=col).fill = FILL_RESET

ws.cell(row=row, column=col).font = FONT_WHITE

row += 1

wb.save(FILENAME)

print(f"[{now}] ===== 영점 리셋 =====")

continue

if not line.startswith("CSV,"):

continue

parts = line.split(",")

parts = parts[1:]

if len(parts) != 13:

continue

try:

time_ms = int(parts[0])

raw_tilt = float(parts[1])

raw_tension = int(parts[2])

raw_dist = int(parts[3])

pct_tilt = float(parts[4])

pct_tension = float(parts[5])

pct_dist = float(parts[6])

score_t = int(parts[7])

score_f = int(parts[8])

score_d = int(parts[9])

total_score = int(parts[10])

level = int(parts[11])

alarm = parts[12]

now = datetime.now().strftime("%H:%M:%S")

ws.append([

time_ms,

raw_tilt, raw_tension, raw_dist,

pct_tilt, pct_tension, pct_dist,

score_t, score_f, score_d,

total_score, level, alarm, now

])

# ── 경보 상태 열 색칠 (13번) ──

if alarm == "DANGER":

ws.cell(row=row, column=13).fill = FILL_DANGER

ws.cell(row=row, column=13).font = FONT_WHITE

elif alarm == "WARNING":

ws.cell(row=row, column=13).fill = FILL_WARNING

ws.cell(row=row, column=13).font = FONT_BLACK

# ── 총점 열 색칠 (11번) ──

if total_score >= 6:

ws.cell(row=row, column=11).fill = FILL_DANGER

ws.cell(row=row, column=11).font = FONT_WHITE

elif total_score >= 3:

ws.cell(row=row, column=11).fill = FILL_WARNING

# ── 센서 점수 열 색칠 (8,9,10번) ──

score_cols = [score_t, score_f, score_d]

for i, score in enumerate(score_cols):

col = 8 + i

if score >= 2:

ws.cell(row=row, column=col).fill = FILL_DANGER

ws.cell(row=row, column=col).font = FONT_WHITE

elif score >= 1:

ws.cell(row=row, column=col).fill = FILL_WARNING

# ── 퍼센트 열 색칠 (5,6,7번) ──

pct_vals = [pct_tilt, pct_tension, pct_dist]

pct_minors = [23.0, 15.0, 20.0]

pct_majors = [37.0, 30.0, 32.0]

for i, (pct, minor, major) in enumerate(zip(pct_vals, pct_minors, pct_majors)):

col = 5 + i

if pct >= major:

ws.cell(row=row, column=col).fill = FILL_DANGER

ws.cell(row=row, column=col).font = FONT_WHITE

elif pct >= minor:

ws.cell(row=row, column=col).fill = FILL_WARNING

row += 1

print(f"[{now}] "

f"기울기:{raw_tilt:.1f}°({pct_tilt:.1f}%/{score_t}pt) "

f"장력:{raw_tension}({pct_tension:.1f}%/{score_f}pt) "

f"거리:{raw_dist}mm({pct_dist:.1f}%/{score_d}pt) "

f"총점:{total_score}pt → {alarm}")

if row % 100 == 0:

wb.save(FILENAME)

print(f"자동 저장! ({row}행)")

except ValueError:

continue

except KeyboardInterrupt:

print("\n종료 중...")

finally:

try:

wb.save(FILENAME)

print(f"저장 완료! → {FILENAME}")

except Exception as e:

print(f"저장 실패: {e}")

finally:

sock.close()
