Billiardchalktheif/Cargo_gaurdian_system/docs/화물지킴이_설계매뉴얼.docx

🚛 화물지킴이 시스템

Arduino UNO R3 하드웨어 설계 및 코딩 매뉴얼

3조 | 2026 캡스톤 디자인

# 1. 시스템 개요

본 시스템은 화물 낙하 사고를 방지하기 위해 3가지 센서를 교차회로(Cross-Zone) 방식으로 운영합니다. 소방 교차회로와 동일하게, 단일 센서 오작동에 의한 오경보를 방지하고 2개 이상의 센서가 동시에 이상을 감지했을 때 단계별 경고를 발령합니다.

## 1-1. 단계별 교차회로 동작 원리

A단계 (모니터링)

- 3개 센서 중 1개가 임계값 초과 → LCD에 주의 표시
- 부저 없음 — 운전자에게 시각적 정보만 제공

B단계 (경고)

- 3개 센서 중 2개 이상이 동시에 임계값 초과 → 부저 간헐 경보 + LCD 경고 표시
- 교차회로 핵심: 2개 센서 교차 확인으로 오경보 대폭 감소

C단계 (위험/제동 권고)

- 3개 센서 모두 임계값 초과 → 부저 연속 경보 + LCD 위험 표시
- 운전자에게 즉시 감속/정차 권고

# 2. 핀 연결 설계도

## 2-1. 전체 핀 연결 표

※ BNO055, VL53L1X, LCD는 모두 I2C 버스를 공유합니다. SDA는 A4, SCL은 A5 한 곳에 묶어서 연결하세요.

센서 | 센서 핀 | Arduino 핀 | 역할 | 비고
BNO055 | VIN | 5V | 전원 공급
BNO055 | GND | GND | 접지
BNO055 | SDA | A4 (SDA) | I2C 데이터 | I2C 버스
BNO055 | SCL | A5 (SCL) | I2C 클럭 | I2C 버스
VL53L1X | VIN | 3.3V | 전원 공급 | 3.3V 주의!
VL53L1X | GND | GND | 접지
VL53L1X | SDA | A4 (SDA) | I2C 데이터 | BNO055와 공유
VL53L1X | SCL | A5 (SCL) | I2C 클럭 | BNO055와 공유
VL53L1X | XSHUT | D7 | 리셋 제어 | 복수 센서시 필요
HX711 | VCC | 5V | 전원 공급
HX711 | GND | GND | 접지
HX711 | DT (DOUT) | D3 | 데이터 출력 | 디지털 핀
HX711 | SCK | D2 | 클럭 | 디지털 핀
LCD (I2C) | VCC | 5V | 전원 공급
LCD (I2C) | GND | GND | 접지
LCD (I2C) | SDA | A4 (SDA) | I2C 데이터 | I2C 버스 공유
LCD (I2C) | SCL | A5 (SCL) | I2C 클럭 | I2C 버스 공유
부저 | ＋ | D9 | 신호 출력 | 능동형 부저
부저 | － | GND | 접지
푸시 버튼 | 한쪽 핀 | D4 | 리셋 입력 | INPUT_PULLUP
푸시 버튼 | 다른 핀 | GND | 접지

## 2-2. I2C 주소 확인 (충돌 방지)

I2C 버스를 여러 기기가 공유하므로, 각 기기의 주소가 겹치지 않아야 합니다.

기기 | 기본 I2C 주소 | 비고
BNO055 | 0x28 (또는 0x29) | ADR핀 GND=0x28, VCC=0x29
VL53L1X | 0x29 | 기본값 — BNO055가 0x28일 때 충돌 없음
LCD (I2C) | 0x27 (또는 0x3F) | 모듈 뒷면 점퍼로 확인

⚠️ VL53L1X 기본 주소가 0x29인데, BNO055를 0x29로 설정하면 충돌합니다. BNO055의 ADR 핀은 반드시 GND에 연결(0x28)하세요.

# 3. 경보 임계값 설계

아래 수치는 초기 권장 임계값입니다. 실제 테스트 후 조정이 필요합니다.

단계 | BNO055 조건 | HX711 조건 | VL53L1X 조건
A단계 (주의) | 기울기 > 5° | 장력 변화 > 10% | 거리 변화 > 5cm
B단계 (경고) | 기울기 > 10° | 장력 변화 > 20% | 거리 변화 > 10cm
C단계 (위험) | 기울기 > 15° | 장력 변화 > 30% | 거리 변화 > 20cm
동작 | LCD 표시 | 부저 간헐 경보 | 부저 연속 + LCD 위험 표시

💡 팁: 처음엔 임계값을 낮게 잡고, 정상 주행 데이터를 시리얼 모니터로 수집한 뒤 기준값을 보정하세요.

# 4. 필수 라이브러리 설치

Arduino IDE → 툴 → 라이브러리 관리에서 아래 라이브러리를 설치하세요.

라이브러리 | 설치 이름 | 용도
Adafruit BNO055 | Adafruit BNO055 | 자이로/IMU 데이터 읽기
Adafruit Unified Sensor | Adafruit Unified Sensor | BNO055 의존 라이브러리
VL53L1X | VL53L1X (pololu) | ToF 거리 센서
HX711 | HX711 arduino library | 로드셀 증폭 IC
LiquidCrystal I2C | LiquidCrystal I2C | I2C LCD 제어
Wire | 내장 (기본 포함) | I2C 통신 (자동 포함)

# 5. Arduino 소스 코드

## 5-1. 전체 코드

아래 코드를 Arduino IDE에 붙여넣고 업로드하세요. 임계값은 3. 섹션 기준입니다.

// ====================================================

// 화물지킴이 시스템 - Arduino UNO R3

// 센서: BNO055(자이로) + HX711(장력) + VL53L1X(거리)

// 교차회로 3단계 경보 방식

// ====================================================

#include <Wire.h>

#include <Adafruit_Sensor.h>

#include <Adafruit_BNO055.h>

#include <VL53L1X.h>

#include <HX711.h>

#include <LiquidCrystal_I2C.h>

// ── 핀 정의 ──────────────────────────────────────

#define HX711_DOUT 3

#define HX711_SCK 2

#define BUZZER_PIN 9

#define BUTTON_PIN 4

#define XSHUT_PIN 7

// ── 임계값 설정 (테스트 후 조정) ──────────────────

#define TILT_A 5.0 // A단계: 기울기(도)

#define TILT_B 10.0 // B단계

#define TILT_C 15.0 // C단계

#define TENSION_A 0.10 // A단계: 장력 변화율 10%

#define TENSION_B 0.20 // B단계

#define TENSION_C 0.30 // C단계

#define DIST_A 50 // A단계: 거리 변화(mm)

#define DIST_B 100 // B단계

#define DIST_C 200 // C단계

// ── 객체 생성 ──────────────────────────────────────

Adafruit_BNO055 bno = Adafruit_BNO055(55, 0x28);

VL53L1X vl53;

HX711 scale;

LiquidCrystal_I2C lcd(0x27, 16, 2);

// ── 전역 변수 ───────────────────────────────────────

float baseWeight = 0; // 캘리브레이션 기준 장력

int baseDist = 0; // 캘리브레이션 기준 거리

bool alert = false; // 알람 상태

// ====================================================

void setup() {

Serial.begin(9600);

Wire.begin();

// 핀 모드

pinMode(BUZZER_PIN, OUTPUT);

pinMode(BUTTON_PIN, INPUT_PULLUP);

pinMode(XSHUT_PIN, OUTPUT);

// LCD 초기화

lcd.init();

lcd.backlight();

lcd.print("HwamuL Guardian");

// BNO055 초기화

if (!bno.begin()) {

lcd.setCursor(0,1); lcd.print("BNO055 ERR!");

while(1);

}

bno.setExtCrystalUse(true);

// VL53L1X 초기화 (XSHUT으로 리셋)

digitalWrite(XSHUT_PIN, LOW);

delay(10);

digitalWrite(XSHUT_PIN, HIGH);

delay(10);

vl53.setTimeout(500);

if (!vl53.init()) {

lcd.setCursor(0,1); lcd.print("VL53 ERR!");

while(1);

}

vl53.setDistanceMode(VL53L1X::Long);

vl53.startContinuous(50);

// HX711 초기화

scale.begin(HX711_DOUT, HX711_SCK);

scale.set_scale(2280.f); // 보정값 - 캘리브레이션 필요

scale.tare(); // 0점 설정

// 기준값 저장 (캘리브레이션)

delay(1000);

baseWeight = scale.get_units(10);

baseDist = vl53.read();

lcd.clear();

lcd.print("Ready!");

delay(1000);

}

// ====================================================

void loop() {

// 리셋 버튼 확인

if (digitalRead(BUTTON_PIN) == LOW) {

alert = false;

noTone(BUZZER_PIN);

lcd.clear(); lcd.print("RESET OK");

delay(1000);

}

// ── 센서 읽기 ──────────────────────────────────

// 1) BNO055 기울기

sensors_event_t event;

bno.getEvent(&event);

float tilt = abs(event.orientation.y); // 롤(쏠림) 각도

// 2) HX711 장력 변화율

float curWeight = scale.get_units(3);

float tensionRatio = abs(curWeight - baseWeight) / (baseWeight + 0.001);

// 3) VL53L1X 거리 변화

int curDist = vl53.read();

int distDiff = abs(curDist - baseDist);

// ── 교차회로 판단 ───────────────────────────────

// 각 센서별 단계 판정 (0=정상 1=A 2=B 3=C)

int stTilt = (tilt >= TILT_C) ? 3 : (tilt >= TILT_B) ? 2 : (tilt >= TILT_A) ? 1 : 0;

int stTension = (tensionRatio >= TENSION_C) ? 3 : (tensionRatio >= TENSION_B) ? 2 : (tensionRatio >= TENSION_A) ? 1 : 0;

int stDist = (distDiff >= DIST_C) ? 3 : (distDiff >= DIST_B) ? 2 : (distDiff >= DIST_A) ? 1 : 0;

// 교차 조건: 활성화된 센서 수 세기

int triggered = (stTilt > 0 ? 1:0) + (stTension > 0 ? 1:0) + (stDist > 0 ? 1:0);

int maxStage = max(stTilt, max(stTension, stDist));

// 최종 경보 단계 결정

// C단계: 3개 모두 활성 OR 최대 단계가 3

// B단계: 2개 이상 활성 OR 최대 단계가 2

// A단계: 1개 활성

int alarmLevel = 0;

if (triggered == 3 || maxStage == 3) alarmLevel = 3;

else if (triggered >= 2 || maxStage == 2) alarmLevel = 2;

else if (triggered >= 1) alarmLevel = 1;

// ── 출력 ────────────────────────────────────────

lcd.clear();

if (alarmLevel == 0) {

lcd.setCursor(0,0); lcd.print("STATUS: NORMAL");

lcd.setCursor(0,1);

lcd.print("T:"); lcd.print((int)tilt);

lcd.print(" F:"); lcd.print((int)(tensionRatio*100));

lcd.print("% D:"); lcd.print(distDiff/10);

noTone(BUZZER_PIN);

}

else if (alarmLevel == 1) {

lcd.setCursor(0,0); lcd.print("[A] CAUTION");

lcd.setCursor(0,1); lcd.print("Check Cargo!");

noTone(BUZZER_PIN);

}

else if (alarmLevel == 2) {

lcd.setCursor(0,0); lcd.print("[B] WARNING!!");

lcd.setCursor(0,1); lcd.print("Cargo Shifting");

tone(BUZZER_PIN, 1000, 200); // 간헐 경보

delay(500);

noTone(BUZZER_PIN);

}

else if (alarmLevel == 3) {

lcd.setCursor(0,0); lcd.print("[C] DANGER!!!");

lcd.setCursor(0,1); lcd.print("SLOW DOWN NOW!");

tone(BUZZER_PIN, 2000); // 연속 경보

}

// 시리얼 디버그 출력

Serial.print("Tilt:"); Serial.print(tilt);

Serial.print(" Tension:"); Serial.print(tensionRatio*100);

Serial.print("% Dist:"); Serial.print(distDiff);

Serial.print("mm Level:"); Serial.println(alarmLevel);

delay(200); // 200ms 주기

}

# 6. 캘리브레이션 절차

## 6-1. HX711 (로드셀) 보정

1. 알려진 무게(예: 1kg 추)를 로드셀에 올린 후 시리얼 모니터 실행
2. scale.get_units() 출력값 확인 → 실제무게 / 출력값 = 보정계수
3. 코드의 set_scale(2280.f) 숫자를 보정계수로 교체

## 6-2. VL53L1X 기준거리 보정

- 화물을 정상 적재 상태로 놓고 전원 인가
- setup() 내에서 자동으로 baseDist 저장됨 (별도 조작 불필요)
- 재적재 시 리셋 버튼(D4) 눌러 기준값 초기화

## 6-3. BNO055 초기 캘리브레이션

- 전원 인가 후 시리얼 모니터에서 calibration status 확인
- Sys/Gyro/Accel/Mag 가 모두 3이 될 때까지 센서를 8자 형태로 천천히 돌리기
- 차량 수평 상태에서 캘리브레이션 완료 후 고정

# 7. 조립 및 테스트 순서

## Step 1 — 브레드보드 기본 배선

- 5V 레일, 3.3V 레일, GND 레일 먼저 구성
- Arduino의 5V → 5V 레일, 3.3V → 3.3V 레일, GND → GND 레일
- VL53L1X는 반드시 3.3V 레일에 연결 (5V 인가 시 파손 주의!)

## Step 2 — I2C 센서 연결

- BNO055 ADR핀 → GND (주소 0x28 고정)
- SDA 라인: BNO055-SDA, VL53L1X-SDA, LCD-SDA 모두 A4에 연결
- SCL 라인: BNO055-SCL, VL53L1X-SCL, LCD-SCL 모두 A5에 연결
- I2C 스캐너 코드로 주소 충돌 확인 (Wire.scan 예제 사용)

## Step 3 — HX711 + 로드셀 연결

- 로드셀 4선(빨강/검정/초록/흰색) → HX711 모듈의 E+/E-/A+/A-에 연결
- HX711 DT → D3, SCK → D2

## Step 4 — 부저 및 버튼

- 능동형 부저 + → D9, - → GND
- 푸시 버튼 한쪽 → D4, 다른 쪽 → GND (INPUT_PULLUP 사용)

## Step 5 — 코드 업로드 및 검증

- 라이브러리 설치 완료 후 코드 붙여넣기
- 시리얼 모니터(9600 baud) 열고 Tilt / Tension / Dist 값 정상 출력 확인
- 화물 정상 상태: 모든 값 0에 가까운지 확인
- 인위적으로 기울이기 → 단계별 경보 발동 테스트

공모전 파이팅! 3조 화물지킴이 🚛
