Billiardchalktheif/Cargo_gaurdian_system/docs/개선방향.docx

<해야될 것>

1. 푸시버튼 연결 관련 개선 방안 -> 최대한 납땜 안되면 푸시버튼을 빵판에 맞게 구매하는 방안 존재
