Billiardchalktheif/Cargo_gaurdian_system/docs/적재물 X 주행테스트 결과 분석.docx

#### 1. 전체 현황

상황 | 총행 | NORMAL | WARNING | DANGER
정상 | 289 | 100% | 0% | 0%
급제동 | 156 | 98.7% | 1.3% | 0%
급커브(좌) | 116 | 100% | 0% | 0%
급커브(우) | 197 | 93.9% | 6.1% | 0%
노면충격 | 158 | 88.6% | 11.4% | 0%

#### 2. 심각한 문제 발견 — 자이로

정상 구간 기울기% 평균: 47.1%

정상 구간 기울기% 최대: 209.5%

정상인데 기울기%가 너무 높아요! 현재 임계값 23%로는 정상 상태에서도 계속 경보 울려요. 자이로 임계값을 훨씬 높여야 해요.

#### 3. 거리 센서는 양호

정상 구간 거리% 최대: 4.2%

급커브(우) 최대: 367.3%

노면충격 최대: 184.3%

정상이랑 위험 구간 차이가 명확해요. 임계값만 조정하면 돼요.

#### 4. 임계값 재추천

cpp

// 자이로 (대폭 상향 필요)

#define TILT_MINOR 2.78 // 278%

#define TILT_MAJOR 4.87 // 487%

// 거리 (소폭 하향)

#define DIST_MINOR 0.07 // 7%

#define DIST_MAJOR 0.12 // 12%

// 장력은 적재물 없어서 신뢰도 낮음 → 유지

#### 5. 중요한 발견

DANGER가 한 번도 안 떴어요!

적재물 없는 상태라 3개 센서가 동시에 심각하게 울리기 어려운 거예요. 적재물 올리고 실험하면 달라질 거예요.

#### 다음 실험 방향

1. 자이로 임계값 대폭 상향 후 재실험

2. 적재물 올리고 동일 상황 반복

3. 장력 센서 래싱벨트 연결 후 벨트 이완 실험
