Billiardchalktheif/Cargo_gaurdian_system/docs/화물지킴이 발표자료.pdf

# 낙하물 피해 사고를 방지하기

# 위하여 주행 중 위험하게 적재된

# 화물을 주변 운전자에게 알리기

여러가지 센서를 활용하여 운전자가 실시간으로 적재 화물 상태를 모니터링 할 수 있는 시스템 구축

### [ 3조 화물지킴이 ]


202136101 강현서 202137539 성준하 202235595 이채원

[2026 1학기 캡스톤 디자인 - 한형석 교수님]


1. 문제인식과 아이디어 도출 | 3조 화물 지킴이


## 운전자가 실시간으로 적재

## 물 확인하고 대비할 방법이

## 없을까?

1. 문제인식과 아이디어 도출 | 3조 화물 지킴이

1

## 왜 치명적인 화물 낙하물 사고가 반복되는가?


1-2. 5 Why ? | 3조 화물 지킴이

1

2

3

4
2

## 왜 화물이 쏠리거나 끈이 풀리는 것을 막지 못하는가?

3

## 왜 운전자는 실시간으로 화물 상태를 알 수 없는가?

4

## 왜 기존의 안전 점검 방식으로는 부족한가?

5

## 왜 기존에는 감지 시스템을 도입하지 않았는가?

주행 중 진동이나 급제동으로 인해 화물을 묶은 끈이 풀리거나 화물이 쏠림

운전자가 주행 중에 적재함의 장력 변화나 화물 형상의 변화를 실시간으로 확인할 수 없음

적재함과 운전석이 분리되어 있어 육안 확인이 불가능하며, 이를 감지할 별 도의 전자 장치가 없음

육안 점검은 '이미 풀린 뒤'에야 발견되는 경우가 많아, 사고 직전의 위험 징 후를 즉각 파악하기 어려움

기존 전문 장비는 고가이거나 설치가 복잡하여 일반 트럭 운전자가 접근하 기 어려움

## 시스템 동작 스케치


2. 시스템 구성 및 동작원리 | 3조 화물 지킴이

S형 로드셀+HX711
장력

VI53L1X 적외선

BNO055 자이로

SENSOR
CASE

## 입력부

## 신호처리부

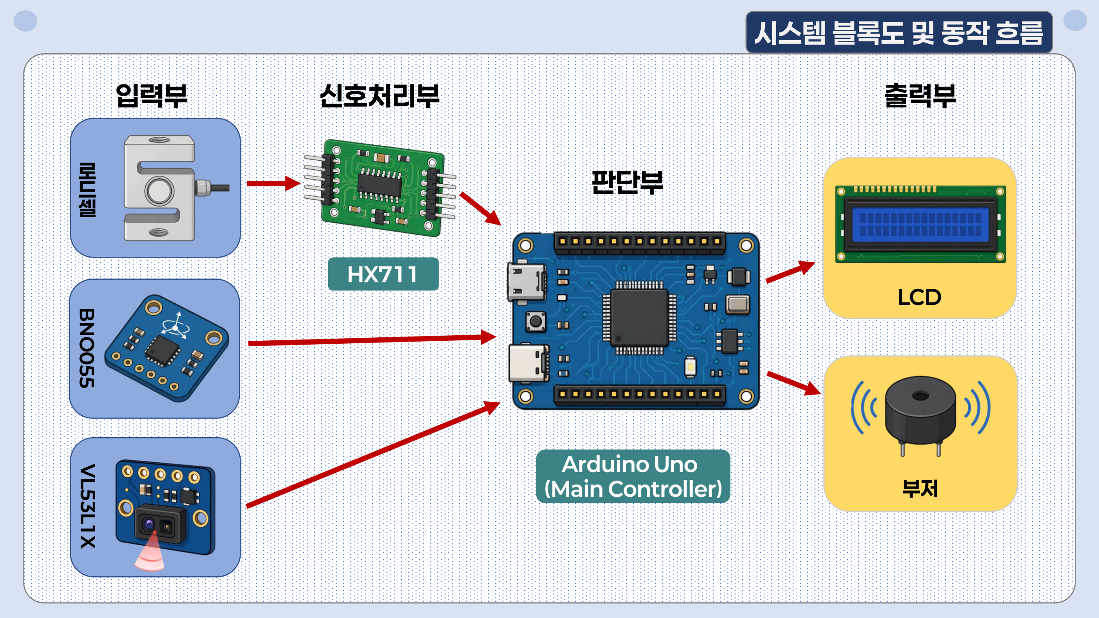
[picture p13: page 6]

Arduino Uno
(Main Controller)

로
드

### 셀BNO055 VL53L1X

## 판단부

## 출력부

LCD

부저

## 시스템 블록도 및 동작 흐름

HX711

2. 시스템 구성 및 동작원리 | 3조 화물 지킴이

## 센서 선정 과정

센서는 테스트 후에 추후 변경될 가능성 있음; ADXL345; BNO055; MPU-6050; 개발 생산성은 중간 정도; 가공된 데이터 를 바로 출력 (알고리즘 개 발 시간 감소); 외부 센서 연 결이 용이함; 저전력 특성. 소형 패키지. 전체 BOM 비 용 절감에도 유리하다; 3개 센서와 MCU가 통합 된 구조; 6축 자이로+가 속도와 DMP 통합 되어있음; NAU7802; ADS1115; 24-bit (초정밀); 24-bit (초정밀; + 저노이즈); 16-bit (일반 정 밀); 가장 저렴함. 모듈화가 잘 되 어 있어 추가 회로 비용 최소 화.; HX711보다 비 싸지만, 정밀도 대비 합리적 가 격.; 장력 전용은 아 니나, 여러 센서 를 동시에 쓸 때 경제적.; 최대 2.0 m (표준형); 최대 4.0 m 장거리형); 상대적으로 저 렴함 (기존 모델); L0X 대비 약간 높으나 성능 우 세; 자이로 센서; 적외선 센서

동작 온도 -40°C ~ + 85°C | 동작 온도 -40°C ~ + 85°C | 동작 온도 -40°C ~ + 105°C.
온도 변화에 따 른 오차가 적음. | 외부 온도 변화 에 따른 장력 값 보정 가능. | -40~140°C작동 범위. 극심한 온 도 변화 환경에 가장 강함.
작동 온도 -20 ~ 70 °C 940nm 적외선 필터 내장 | 작동 온도 -20 ~ 85 °C 내장 렌즈 및 SPAD 어레이

### 2. 시스템 구성

### 및 동작원리

3

조 화물 지킴이

## 예상 부품

## 및 가격


# 기대효과

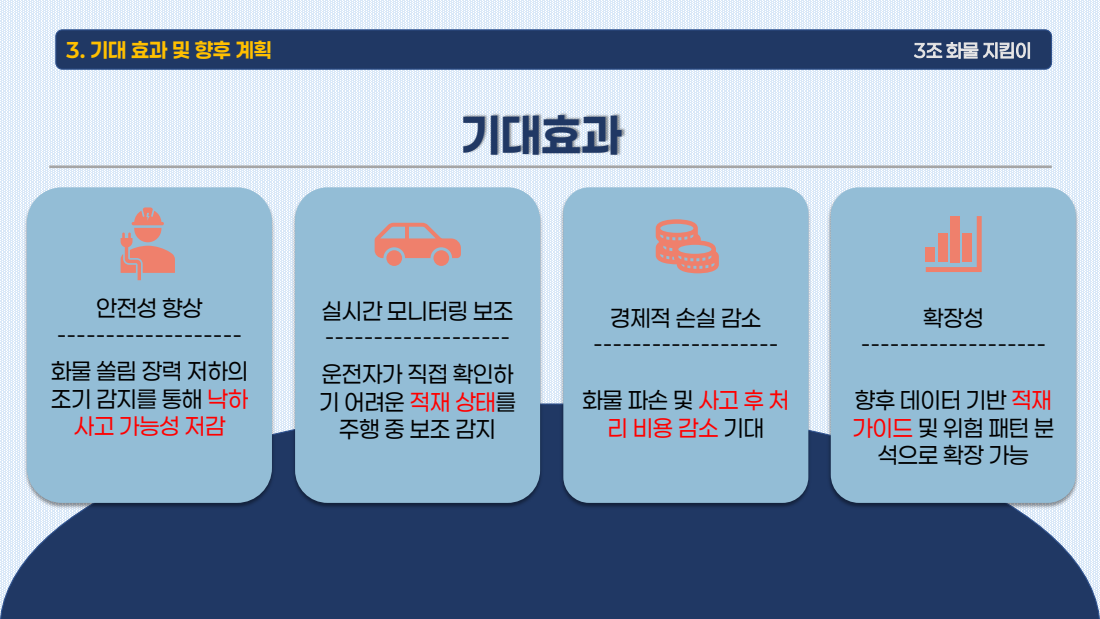
[picture p14: page 9]
3조 화물 지킴이; 확장성 -------------------

안전성 향상
화물 쏠림 장력 저하의
조기 감지를 통해 낙하
사고 가능성 저감

실시간 모니터링 보조
운전자가 직접 확인하
기 어려운 적재 상태를

경제적 손실 감소

향후 데이터 기반 적재
가이드 및 위험 패턴 분
석으로 확장 가능

3조 화물 지킴이; 일시적 노면 충격과 실제 화물 쏠림을 구분할 수 있는가; 성능 검증 항목 (체크 리스트); 외부 간섭 및 비정상 입력에 대해 오검출을 줄일 수 있는가; 다중 센서 사용 시 데이터를 통합 처리할 수 있는가; 쏠림 검출 성공률: 80% 이상; 정상 상태 오경보율: 20% 이하
