Billiardchalktheif/Cargo_gaurdian_system/docs/images/sensor_analysis.png

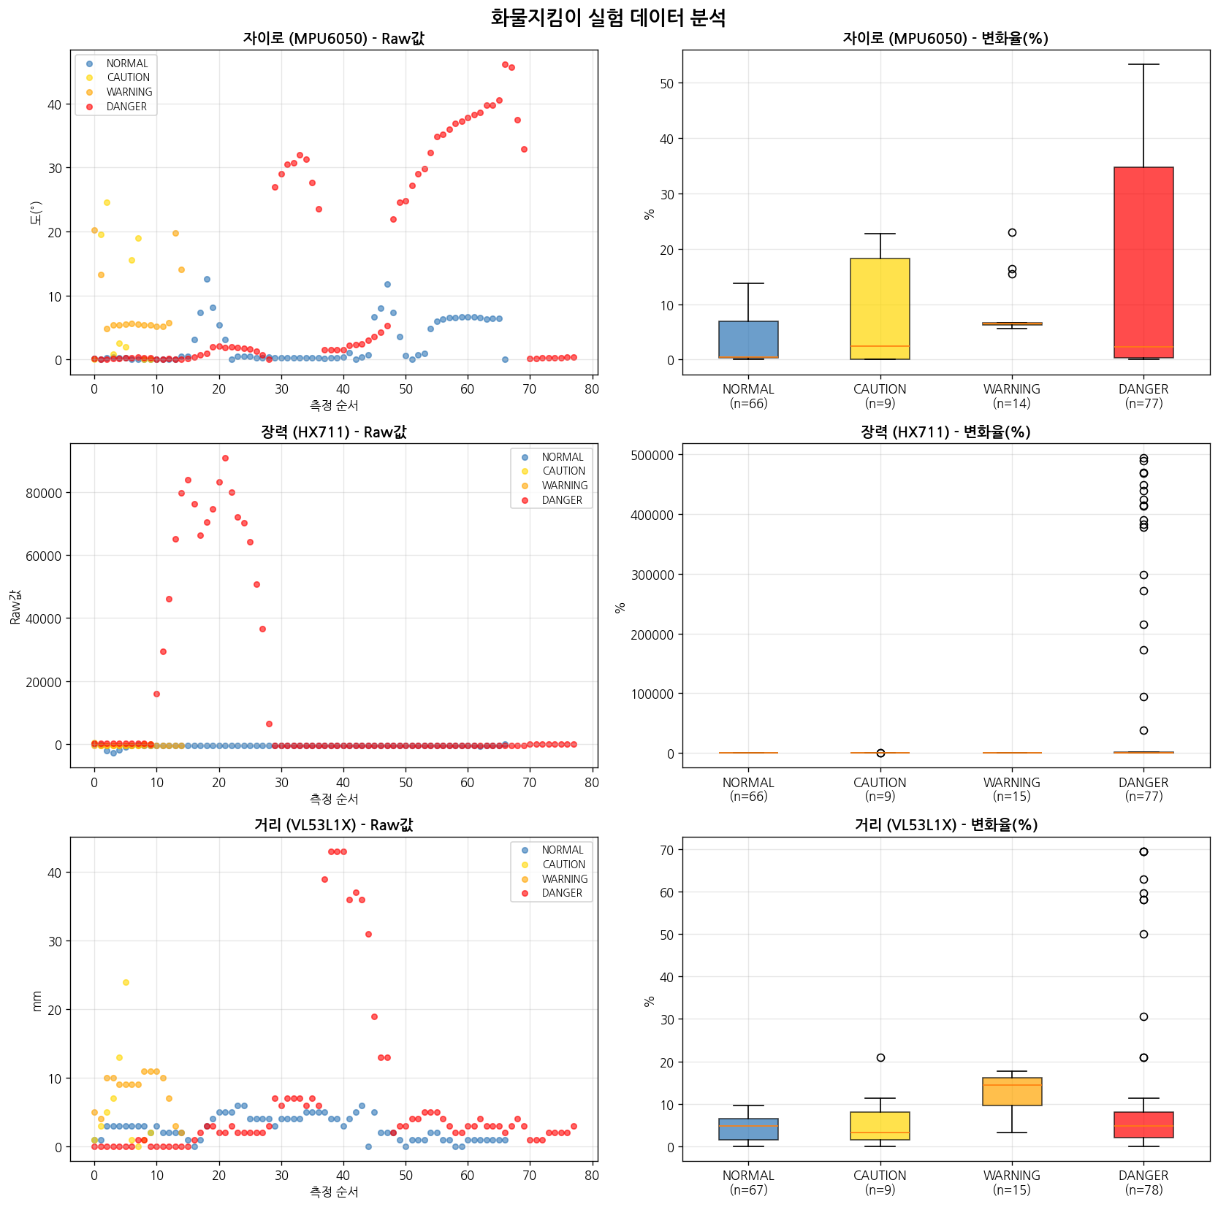
docs/images/sensor_analysis.png
