Billiardchalktheif/Cargo_gaurdian_system/docs/images/timeseries_analysis.png

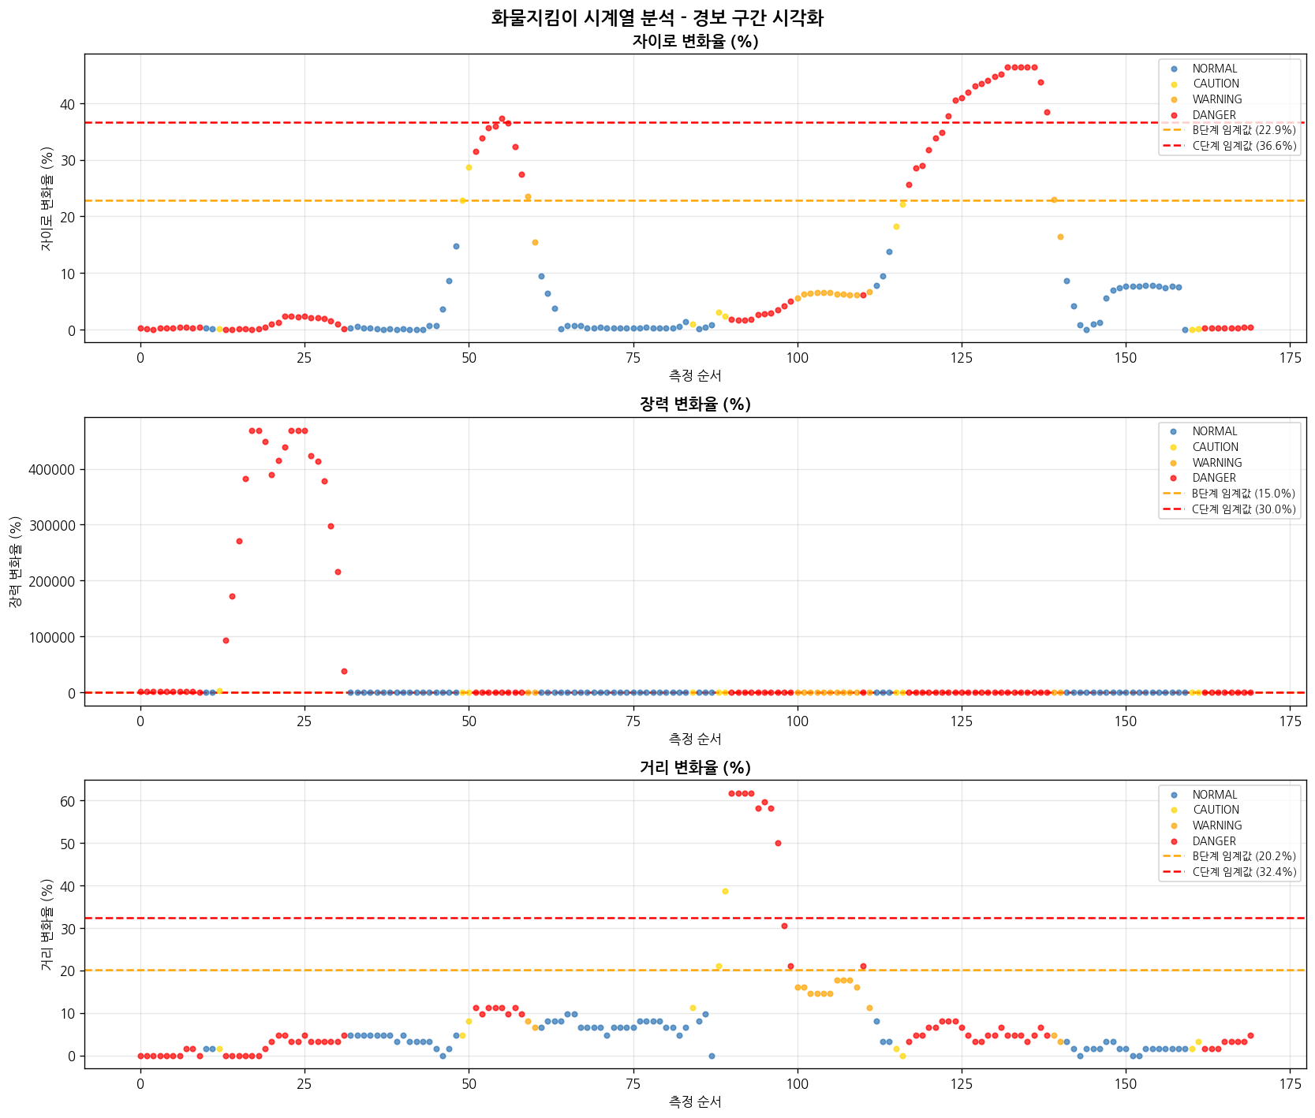
docs/images/timeseries_analysis.png
